alchemy3d/Voron-Hardware/Daylight/Flashbang_on_a_matchstick/README.md

# Flashbang on a matchstick

# BETA, DO NOT USE

12 White leds and 9 RGB leds to accurately illuminate your V0 or other ant-sized printer.

## BOM
| Quantity | Value | Package |
|---|---|---|
| 4 | 100 Ohms Resistor | 1210 |
| 12 | White LED (4000K, 90+ CRI) | 2835 |
| 9 | WS2812B LED | 5050 |
| 2 | Molex Nano-Fit 3x2 angled connector| 2pin |

## Changelog

### V0.0
Initial beta;
