alchemy3d/Voron-Hardware/Daylight/Flashbang_on_a_stick/README.md

# Daylight on a stick

18 White leds to accurately illuminate your Voron.

## BOM
| Quantity | Value | Package |
|---|---|---|
| 6 | 100 Ohms Resistor | 1210 |
| 18 | White LED (4000K, 90+ CRI) | 2835 |
| 2 | JST-XH (2.54) angled connector| 2pin |

## Changelog

### V1.2
Fixed a short on the trace between the first and second led.

### V1.1
Initial public release.
