alchemy3d/Voron-Hardware/Daylight/Flashbang_on_a_stick_XXL/README.md

# Daylight on a stick XXL

30 White leds to accurately illuminate your Voron. 
Meant for 350 size printers.

## BOM
| Quantity | Value | Package |
|---|---|---|
| 10 | 100 Ohms Resistor | 1210 |
| 30 | White LED (4000K, 90+ CRI) | 2835 |
| 2 | JST-XH (2.54) angled connector| 2pin |

## Changelog

### V1.2
Initial public release. Based upon Daylight on a Stick V1.2
