alchemy3d/Voron-Hardware/Daylight/Flashbang_on_a_matchstick/Flashbang_Matchstick.kicad_pcb

## KiCad design Daylight/Flashbang_on_a_matchstick/Flashbang_Matchstick.kicad_pcb (2023-08-31)

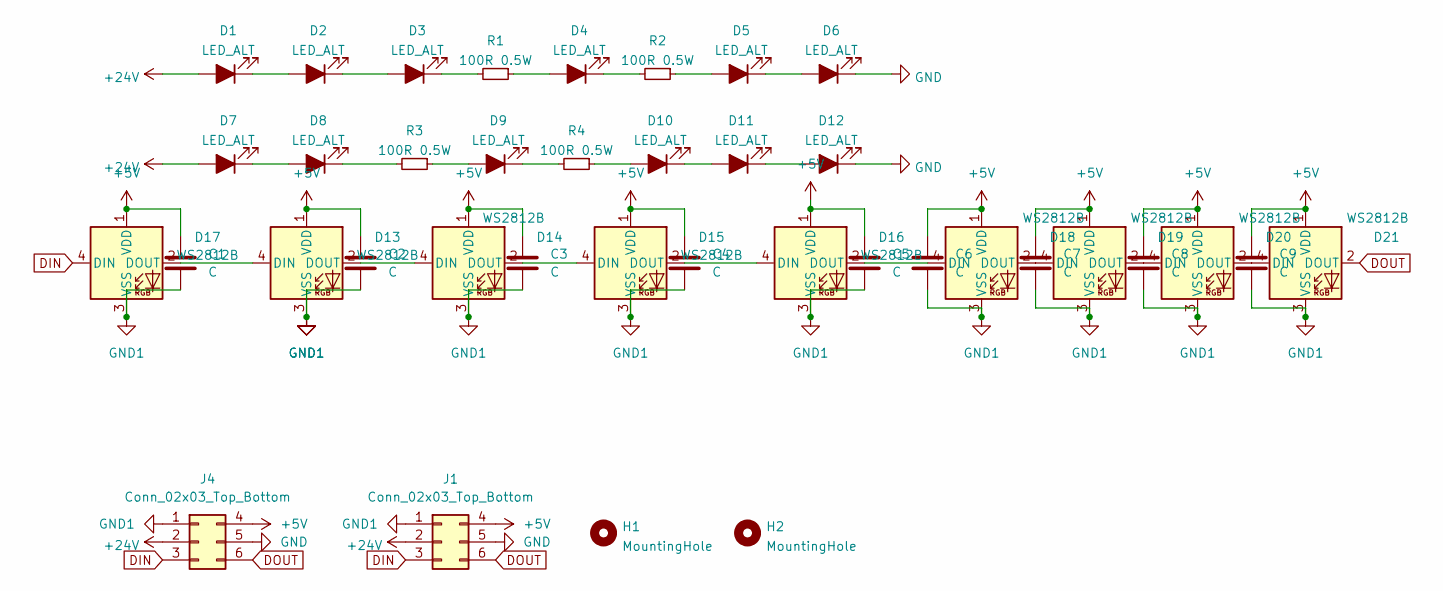
[picture p1: schematic Flashbang_Matchstick.kicad_sch]

Parts:
C1, C2, C3, C4, C5, C6, C7, C8, C9: C; C_0603_1608Metric
D1, D2, D3, D4, D5, D6, D7, D8, D9, D10, D11, D12: LED_ALT; LED_PLCC_2835_Handsoldering; LCSC C182223
D13, D14, D15, D16, D17, D18, D19, D20, D21: WS2812B; LED_WS2812B_PLCC4_5.0x5.0mm_P3.2mm
H1, H2: MountingHole; MountingHole_3.2mm_M3_Pad_Via
J1, J4: Conn_02x03_Top_Bottom; Molex_Nano-Fit_105314-xx06_2x03_P2.50mm_Horizontal
R1, R2, R3, R4: 100R 0.5W; R_1210_3225Metric_Pad1.30x2.65mm_HandSolder; LCSC C137089

Connections:
+5V: C1.1, C2.1, C3.1, C4.1, C5.1, C6.1, C7.1, C8.1, C9.1, D13.1 (VDD), D14.1 (VDD), D15.1 (VDD), D16.1 (VDD), D17.1 (VDD), D18.1 (VDD), D19.1 (VDD), D20.1 (VDD), D21.1 (VDD), J1.4, J4.4
+24V: D1.2 (A), D7.2 (A), J1.2, J4.2
DIN: D17.4 (DIN), J1.3, J4.3
DOUT: D21.2 (DOUT), J1.6, J4.6
GND: D6.1 (K), D12.1 (K), J1.5, J4.5
GND1: C1.2, C2.2, C3.2, C4.2, C5.2, C6.2, C7.2, C8.2, C9.2, D13.3 (VSS), D14.3 (VSS), D15.3 (VSS), D16.3 (VSS), D17.3 (VSS), D18.3 (VSS), D19.3 (VSS), D20.3 (VSS), D21.3 (VSS), J1.1, J4.1
unnamed: D1.1 (K), D2.2 (A)
unnamed: D2.1 (K), D3.2 (A)
unnamed: D3.1 (K), R1.2
unnamed: D4.2 (A), R1.1
unnamed: D4.1 (K), R2.2
unnamed: D5.2 (A), R2.1
unnamed: D5.1 (K), D6.2 (A)
unnamed: D7.1 (K), D8.2 (A)
unnamed: D8.1 (K), R3.2
unnamed: D9.2 (A), R3.1
unnamed: D9.1 (K), R4.2
unnamed: D10.2 (A), R4.1
unnamed: D10.1 (K), D11.2 (A)
unnamed: D11.1 (K), D12.2 (A)
unnamed: D13.4 (DIN), D17.2 (DOUT)
unnamed: D13.2 (DOUT), D14.4 (DIN)
unnamed: D14.2 (DOUT), D15.4 (DIN)
unnamed: D15.2 (DOUT), D16.4 (DIN)
unnamed: D16.2 (DOUT), D18.4 (DIN)
unnamed: D18.2 (DOUT), D19.4 (DIN)
unnamed: D19.2 (DOUT), D20.4 (DIN)
unnamed: D20.2 (DOUT), D21.4 (DIN)

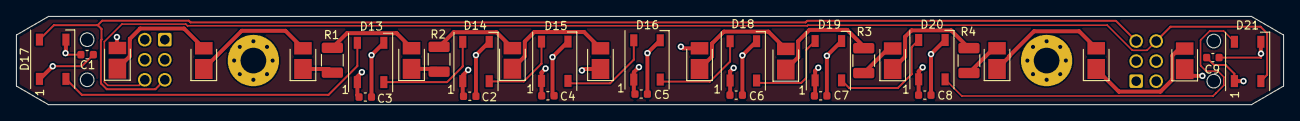
[picture p2: board Flashbang_Matchstick.kicad_pcb from above]

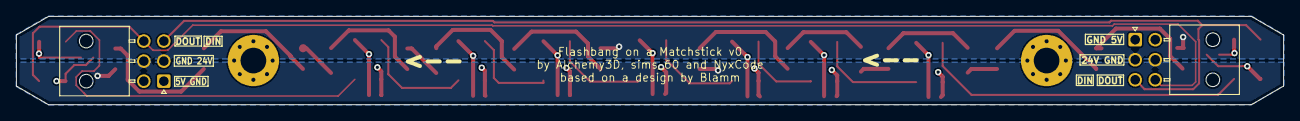
[picture p3: board Flashbang_Matchstick.kicad_pcb from below]

Board: 4 copper layers, 158.0 x 11.0 mm, 38 parts (2 on the bottom side), 28 nets.
