alchemy3d/Voron-Hardware/Daylight/Flashbang_on_a_stick_XXL/Daylight_XXL.kicad_pcb

## KiCad design Daylight/Flashbang_on_a_stick_XXL/Daylight_XXL.kicad_pcb (2023-08-30)

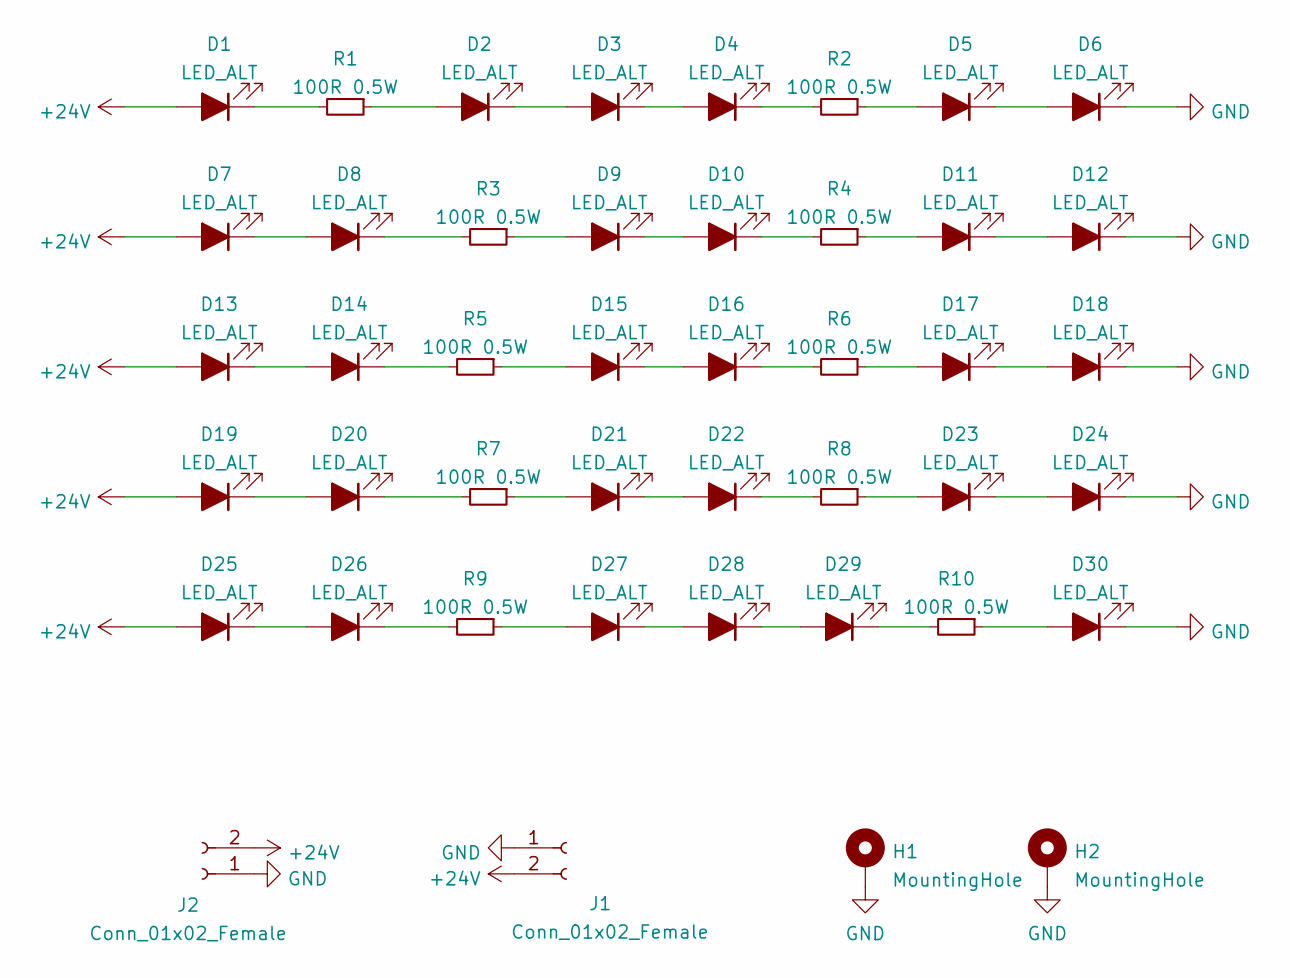
[picture p4: schematic Daylight_XXL.kicad_sch]

Parts:
D1, D2, D3, D4, D5, D6, D7, D8, D9, D10, D11, D12, D13, D14, D15, D16, D17, D18, D19, D20, D21, D22, D23, D24, D25, D26, D27, D28, D29, D30: LED_ALT; LED_PLCC_2835_Handsoldering; LCSC C182223
H1, H2: MountingHole; MountingHole_3.2mm_M3_Pad_Via
J1: Conn_01x02_Female; PinHeader_1x02_P2.54mm_Horizontal_mirrored
J2: Conn_01x02_Female; PinHeader_1x02_P2.54mm_Horizontal
R1, R2, R3, R4, R5, R6, R7, R8, R9, R10: 100R 0.5W; R_1210_3225Metric_Pad1.30x2.65mm_HandSolder; LCSC C137089

Connections:
+24V: D1.2 (A), D7.2 (A), D13.2 (A), D19.2 (A), D25.2 (A), J1.2, J2.2
GND: D6.1 (K), D12.1 (K), D18.1 (K), D24.1 (K), D30.1 (K), H1.1, H2.1, J1.1, J2.1
unnamed: D1.1 (K), R1.2
unnamed: D2.1 (K), D3.2 (A)
unnamed: D4.1 (K), R2.2
unnamed: D3.1 (K), D4.2 (A)
unnamed: D5.1 (K), D6.2 (A)
unnamed: D5.2 (A), R2.1
unnamed: D7.1 (K), D8.2 (A)
unnamed: D8.1 (K), R3.2
unnamed: D9.2 (A), R3.1
unnamed: D10.1 (K), R4.2
unnamed: D9.1 (K), D10.2 (A)
unnamed: D11.1 (K), D12.2 (A)
unnamed: D11.2 (A), R4.1
unnamed: D13.1 (K), D14.2 (A)
unnamed: D14.1 (K), R5.2
unnamed: D15.1 (K), D16.2 (A)
unnamed: D15.2 (A), R5.1
unnamed: D16.1 (K), R6.2
unnamed: D17.1 (K), D18.2 (A)
unnamed: D19.1 (K), D20.2 (A)
unnamed: D20.1 (K), R7.2
unnamed: D21.1 (K), D22.2 (A)
unnamed: D21.2 (A), R7.1
unnamed: D22.1 (K), R8.2
unnamed: D23.1 (K), D24.2 (A)
unnamed: D23.2 (A), R8.1
unnamed: D25.1 (K), D26.2 (A)
unnamed: D26.1 (K), R9.2
unnamed: D27.1 (K), D28.2 (A)
unnamed: D27.2 (A), R9.1
unnamed: D28.1 (K), D29.2 (A)
unnamed: D29.1 (K), R10.2
unnamed: D30.2 (A), R10.1
unnamed: D2.2 (A), R1.1
unnamed: D17.2 (A), R6.1

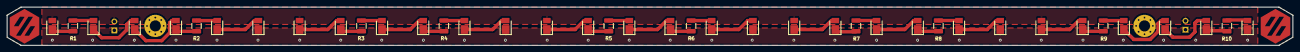
[picture p5: board Daylight_XXL.kicad_pcb from above]

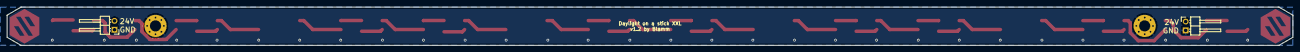
[picture p6: board Daylight_XXL.kicad_pcb from below]

Board: 2 copper layers, 370.0 x 11.0 mm, 44 parts (2 on the bottom side), 37 nets.
