alchemy3d/Voron-Hardware/(commit log)

2023-08-30 Add Daylight copy as base for flashbang
    [BOM-Daylight.csv, BOM-Daylight_Matchstick.csv, BOM-Daylight_XXL.csv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]
2023-08-31 Flashbang on a matchstick added
    [BOM-Daylight_Matchstick.csv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]
